codingasdf/RCL_Testing_System/hardware/fullsystem_8051_bom.xlsx

Comment | Description | Designator | Footprint | LibRef | Quantity
103 | 独石电容 | C1, C2, C5, C9 | MLCC5.08-A | C-MLCC | 4
30 | 瓷片电容 | C3, C4 | CC 1.8*3.6 | CC | 2
104 | 独石电容 | C6, C7, C8, C10 | MLCC5.08-A | C-MLCC | 4
10uF/25V | 直插电解电容 | CE1 | CAP 1.5*4*8 | CE | 1
3.5*1.3 | 低压电源接口 | CON1 | DC-005 | P-DC | 1
HDR-1X16 | 16P接插件 | JP1 | HDR2.54-M-LI-16P | Header 16 | 1
HDR-1X20 | 20P接插件 | JP2, JP3 | HDR2.54-LI-20P | Header 20 | 2
HDR-1X2 | 2P接插件 | JP4, JP6, JP9 | HDR2.54-LI-2P | Header 2 | 3
HDR-1X2 | 2P接插件 | JP5, JP7, JP10 | HDR2.54-M-LI-2P | Header 2 | 3
HDR-1X3 | 3P接插件 | JP8 | HDR2.54-Y-LI-3P | Header 3 | 1
HDR-1X8 | 8P接插件 | JP11, JP12 | HDR2.54-LI-8P | Header 8 | 2
HDR-1X2 | 2P接插件 | JP13, JP14 | KF128-5.08-2P | Header 2 | 2
黄色 | 直插5mm LED | LED1, LED2, LED3, LED4, LED5 | LED 5MM-Y | LED-5MM | 5
S9013 | 低频放大-NPN型 | Q1, Q2 | TO92A | 9013-DIP | 2
103 | 9脚直插排阻 | R1 | R SIP9-2.54 | R SIP9 | 1
1K | 色环电阻 | R2, R3, R4, R5, R6, R13 | RS 1/4W | R-S | 6
10K | 色环电阻 | R7, R10, R11, R12 | RS 1/4W | R-S | 4
1M | 色环电阻 | R8 | RS 1/4W | R-S | 1
500K | 色环电阻 | R9 | RS 1/4W | R-S | 1
10K | 单联电位器 | RP1 | RM065 | RP | 1
1K | 单联电位器 | RP2 | RM065 | RP | 1
100K | 单联电位器 | RP3 | RM065 | RP | 1
200K | 单联电位器 | RP4 | RM065 | RP | 1
RS26_3*4 |  | SW1 | RS26_3*4 | RS26_3*4 | 1
KET 8X8 | 8*8自锁开关 | SW2 | KFT DIP-8X8 | KET 8X8 | 1
6x6x5 | 直插6x6轻触开关 | SW3 | TSW DIP-6*6*4.3 | TSW DIP-6x6 | 1
STC89C52RC | STC单片机 | U1 | DIP40-600 | STC89C52RC | 1
NE555 | 单路时基芯片 | U2, U3, U5 | DIP8-300_MH | NE555 | 3
4052 |  | U4 | DIP-16 | 4052 | 1
