codingasdf/RCL_Testing_System/hardware/fullsystem_8051.pdf

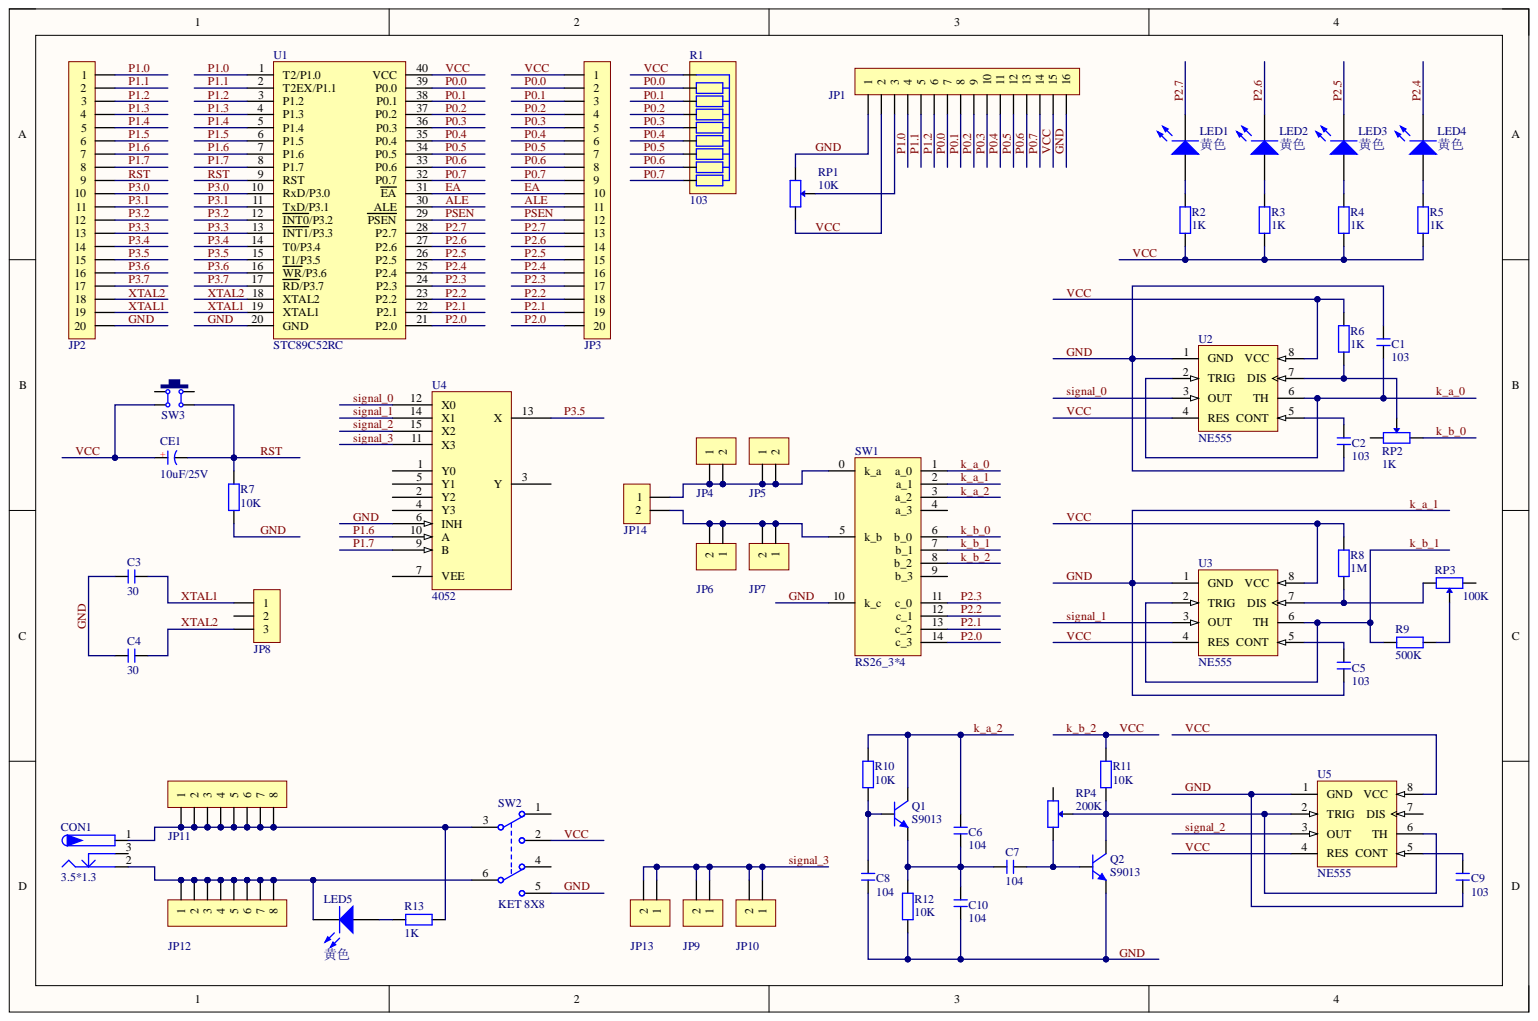
[picture p4: page 1]

2 | TRIG DIS O U T T H RE S CO N T
3 | | 6 5

2 | TRIG DIS O U T T H RE S CO N T | 7
